tobydiamonds/kosmo-16-channel-midi-sequencer/frontpanel mockup.png

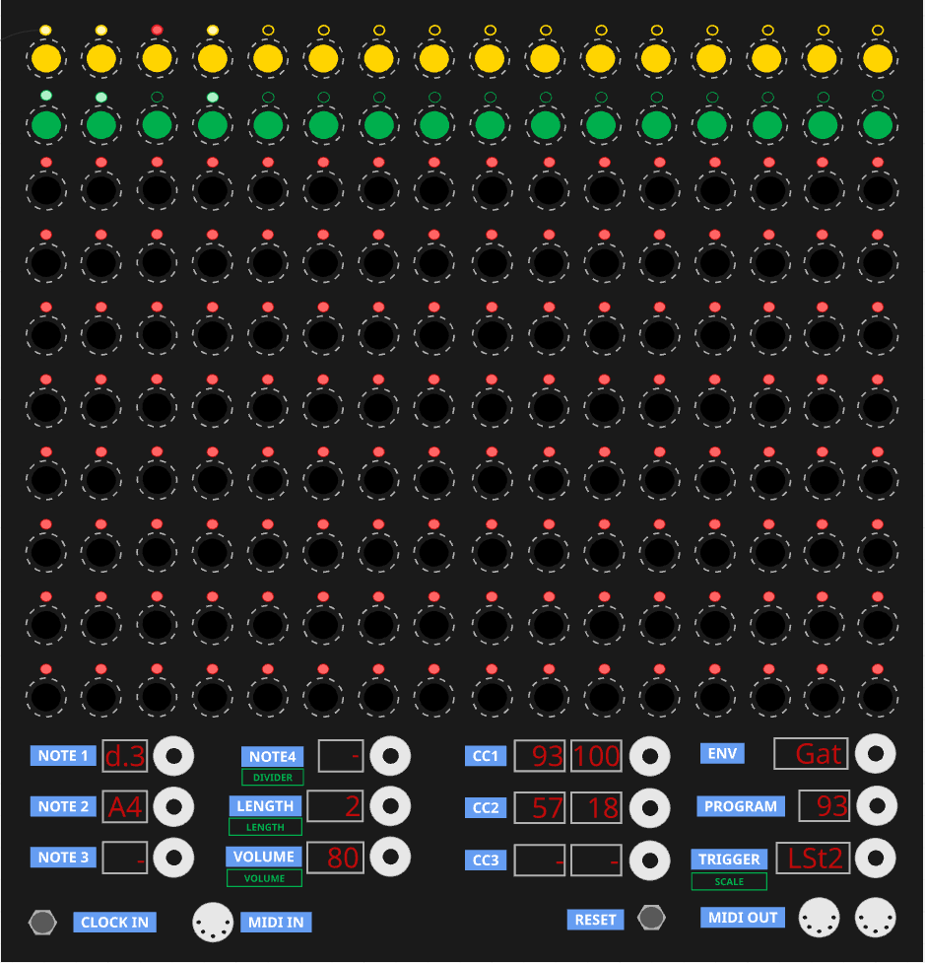
frontpanel mockup.png
