tobydiamonds/kosmo-16-channel-midi-sequencer/kosmo-16-channel-sequencer-centered.png

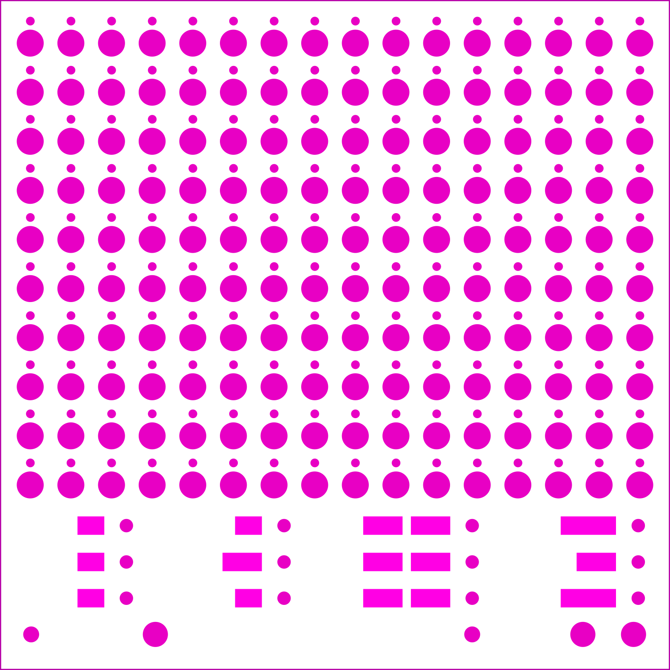
kosmo-16-channel-sequencer-centered.png
