tobydiamonds/kosmo-16-channel-midi-sequencer/kosmo-16-channel-sequencer-centered.pdf

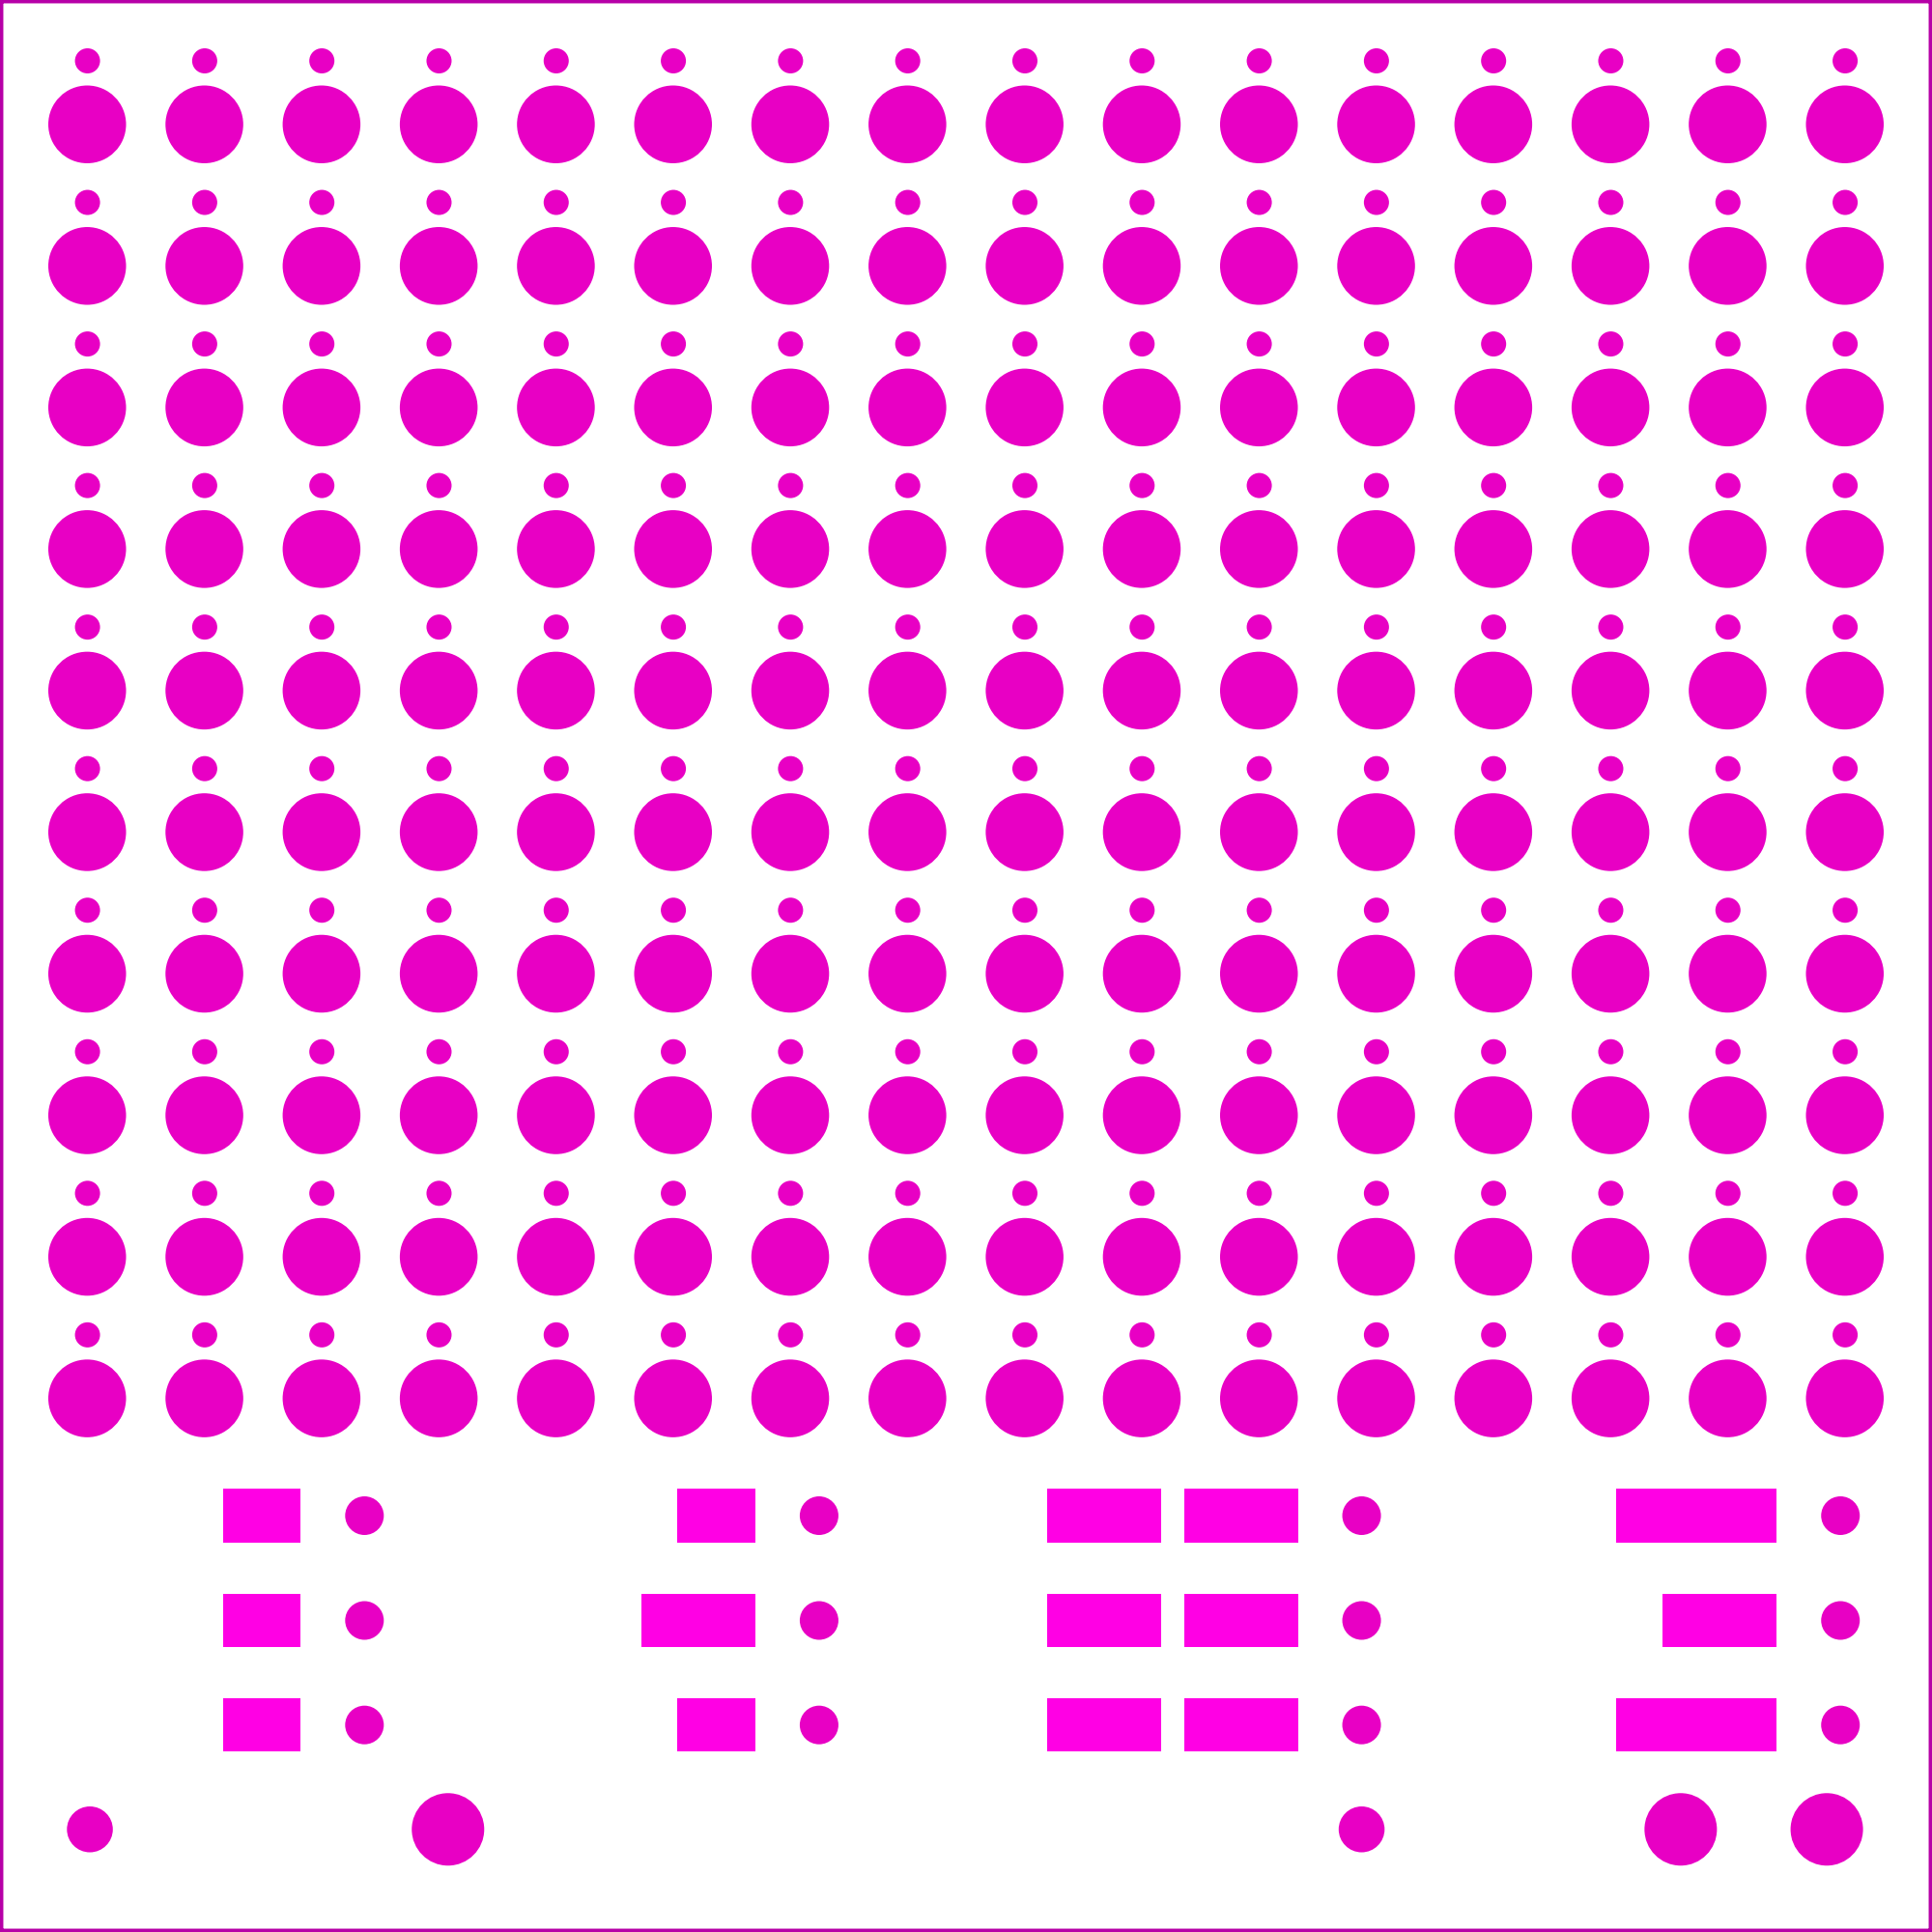
[picture p3: page 1]
