tobydiamonds/kosmo-16-channel-midi-sequencer/hardware/kosmo-16-channel-sequencer-row-board/kosmo-16-channel-sequencer-row-board.kicad_pcb

## KiCad design hardware/kosmo-16-channel-sequencer-row-board/kosmo-16-channel-sequencer-row-board.kicad_pcb (2026-09-22)

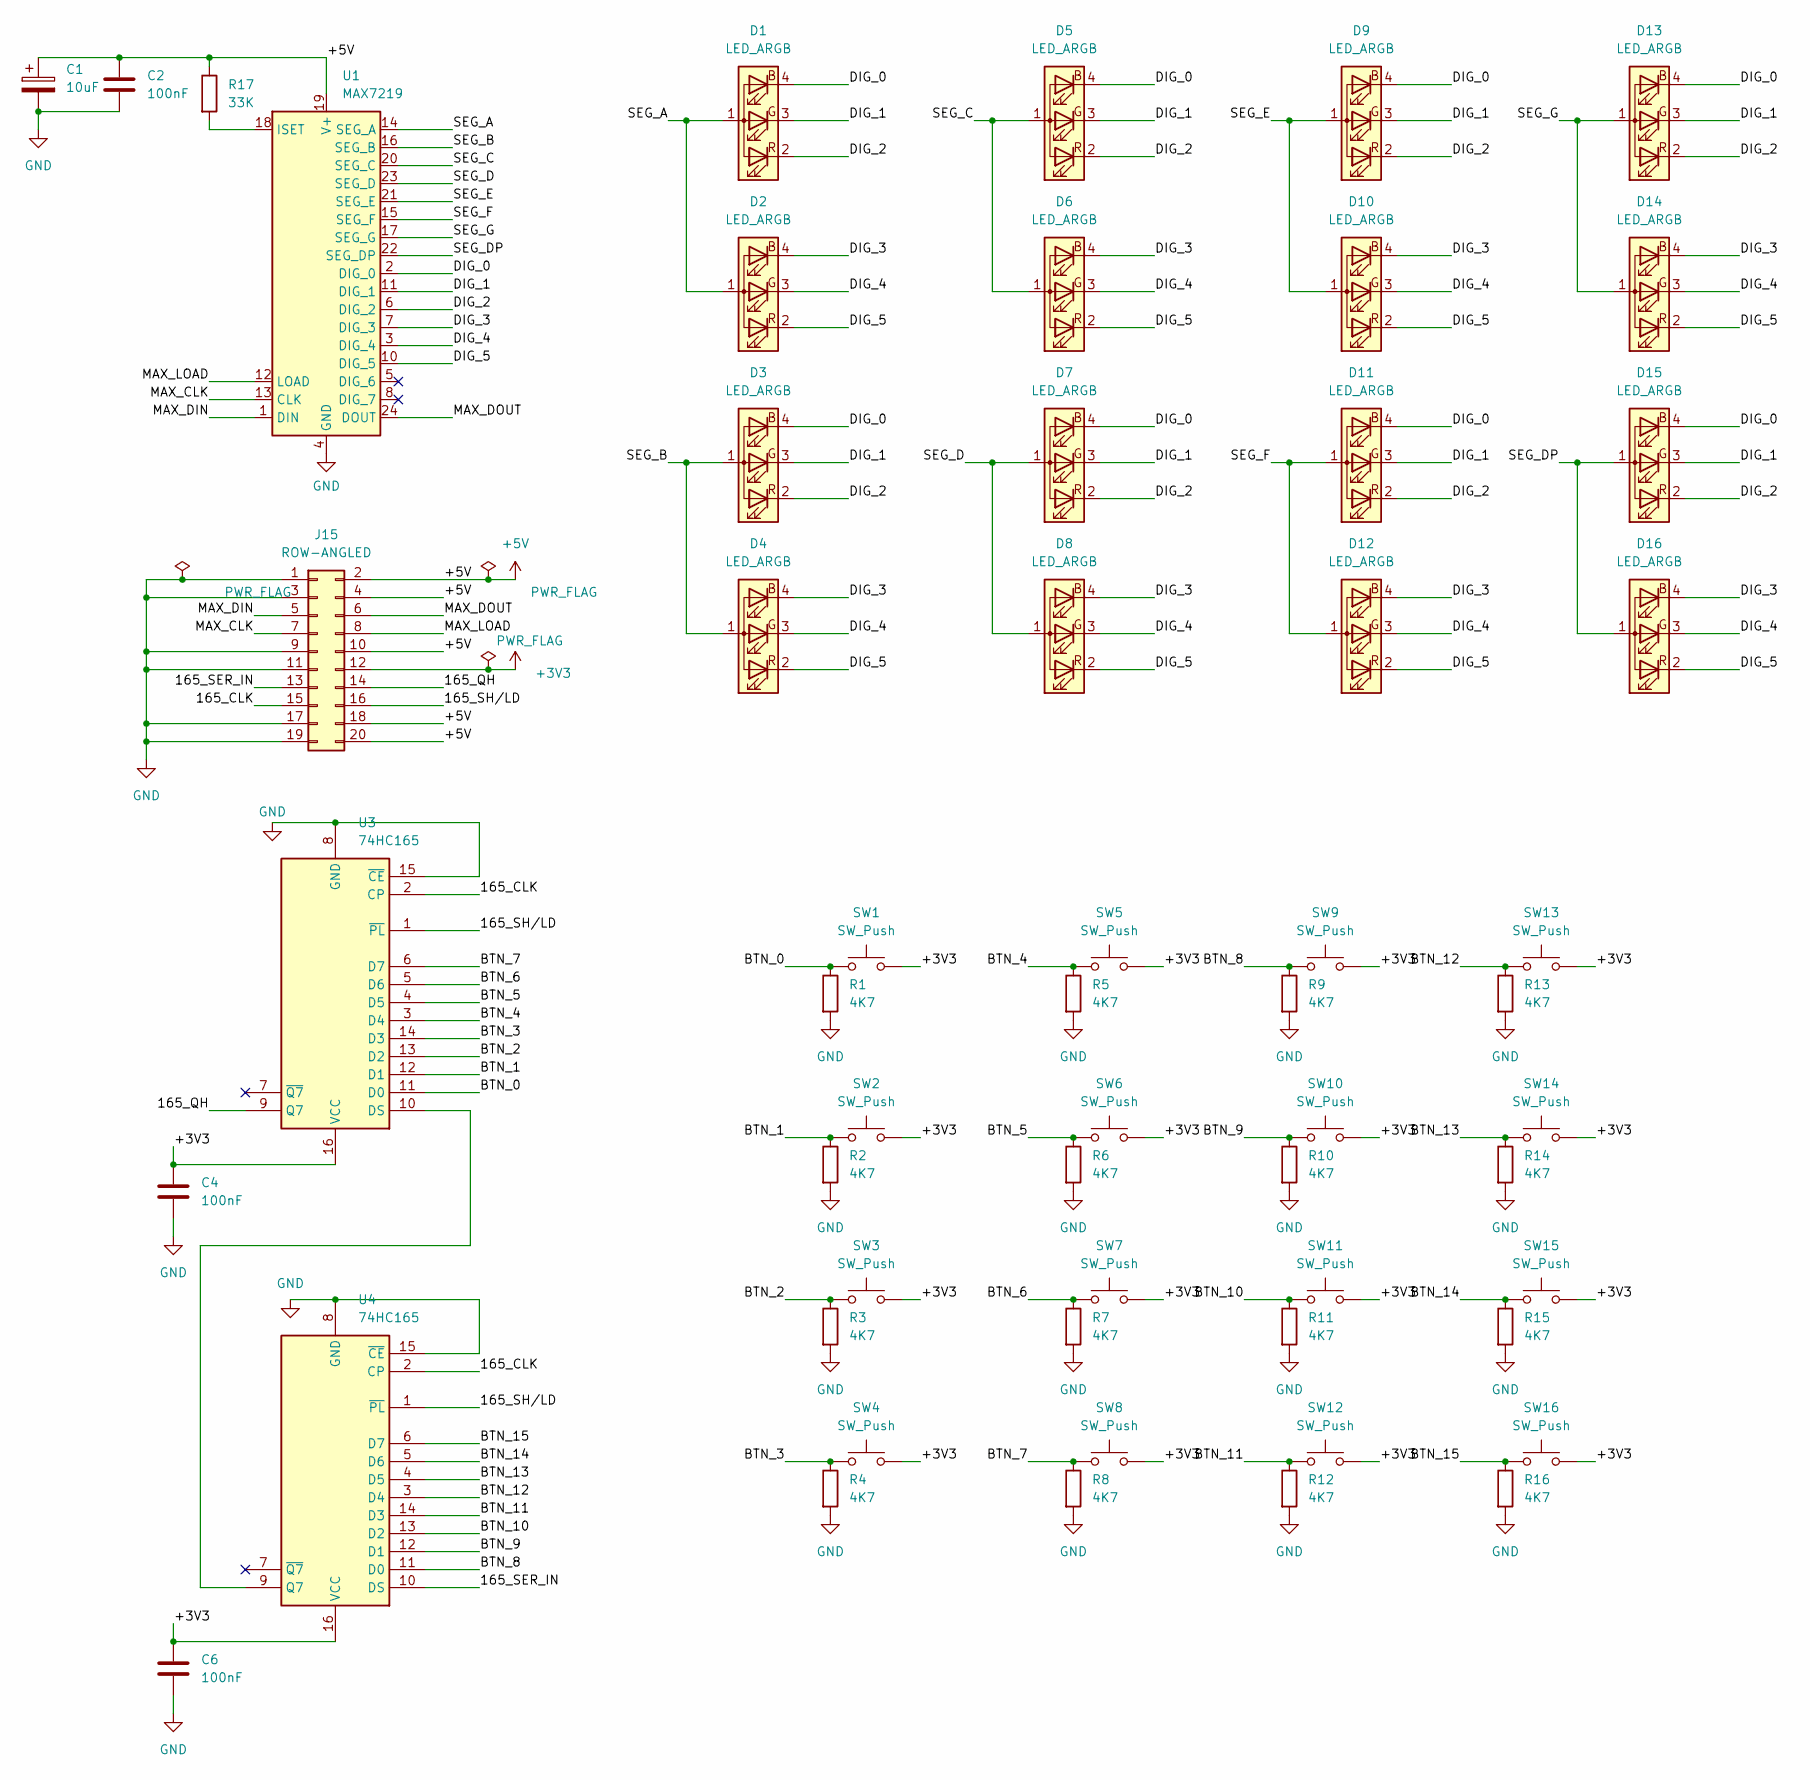
[picture p4: schematic kosmo-16-channel-sequencer-row-board.kicad_sch]

Parts:
C1: 10uF; CP_Radial_D6.3mm_P2.50mm
C2, C4, C6: 100nF; C_Disc_D5.0mm_W2.5mm_P5.00mm
D1, D2, D3, D4, D5, D6, D7, D8, D9, D10, D11, D12, D13, D14, D15, D16: LED_ARGB; LED_D5.0mm-4_RGB-common-anode
J15: ROW-ANGLED; PinHeader_2x10_P2.54mm_Vertical
R1, R2, R3, R4, R5, R6, R7, R8, R9, R10, R11, R12, R13, R14, R15, R16: 4K7; R_Axial_DIN0207_L6.3mm_D2.5mm_P7.62mm_Horizontal
R17: 33K; R_Axial_DIN0207_L6.3mm_D2.5mm_P7.62mm_Horizontal
SW1, SW2, SW3, SW4, SW5, SW6, SW7, SW8, SW9, SW10, SW11, SW12, SW13, SW14, SW15, SW16: SW_Push; PinHeader_1x02_P2.54mm_Vertical
U1: MAX7219; SMDIP-24_W15.24mm
U3, U4: 74HC165; DIP-16_W7.62mm

Connections:
+3V3: C4.1, C6.1, J15.12, SW1.2, SW2.2, SW3.2, SW4.2, SW5.2, SW6.2, SW7.2, SW8.2, SW9.2, SW10.2, SW11.2, SW12.2, SW13.2, SW14.2, SW15.2, SW16.2, U3.16 (VCC), U4.16 (VCC)
+5V: C1.1, C2.1, J15.2, J15.4, J15.10, J15.18, J15.20, R17.1, U1.19 (V+)
/165_CLK: J15.15, U3.2 (CP), U4.2 (CP)
/165_QH: J15.14, U3.9 (Q7)
/165_SER_IN: J15.13, U4.10 (DS)
/165_SH/LD: J15.16, U3.1 (~PL), U4.1 (~PL)
/BTN_0: R1.1, SW1.1, U3.11 (D0)
/BTN_1: R2.1, SW2.1, U3.12 (D1)
/BTN_2: R3.1, SW3.1, U3.13 (D2)
/BTN_3: R4.1, SW4.1, U3.14 (D3)
/BTN_4: R5.1, SW5.1, U3.3 (D4)
/BTN_5: R6.1, SW6.1, U3.4 (D5)
/BTN_6: R7.1, SW7.1, U3.5 (D6)
/BTN_7: R8.1, SW8.1, U3.6 (D7)
/BTN_8: R9.1, SW9.1, U4.11 (D0)
/BTN_9: R10.1, SW10.1, U4.12 (D1)
/BTN_10: R11.1, SW11.1, U4.13 (D2)
/BTN_11: R12.1, SW12.1, U4.14 (D3)
/BTN_12: R13.1, SW13.1, U4.3 (D4)
/BTN_13: R14.1, SW14.1, U4.4 (D5)
/BTN_14: R15.1, SW15.1, U4.5 (D6)
/BTN_15: R16.1, SW16.1, U4.6 (D7)
/DIG_0: D1.4 (BK), D3.4 (BK), D5.4 (BK), D7.4 (BK), D9.4 (BK), D11.4 (BK), D13.4 (BK), D15.4 (BK), U1.2 (DIG_0)
/DIG_1: D1.3 (GK), D3.3 (GK), D5.3 (GK), D7.3 (GK), D9.3 (GK), D11.3 (GK), D13.3 (GK), D15.3 (GK), U1.11 (DIG_1)
/DIG_2: D1.2 (RK), D3.2 (RK), D5.2 (RK), D7.2 (RK), D9.2 (RK), D11.2 (RK), D13.2 (RK), D15.2 (RK), U1.6 (DIG_2)
/DIG_3: D2.4 (BK), D4.4 (BK), D6.4 (BK), D8.4 (BK), D10.4 (BK), D12.4 (BK), D14.4 (BK), D16.4 (BK), U1.7 (DIG_3)
/DIG_4: D2.3 (GK), D4.3 (GK), D6.3 (GK), D8.3 (GK), D10.3 (GK), D12.3 (GK), D14.3 (GK), D16.3 (GK), U1.3 (DIG_4)
/DIG_5: D2.2 (RK), D4.2 (RK), D6.2 (RK), D8.2 (RK), D10.2 (RK), D12.2 (RK), D14.2 (RK), D16.2 (RK), U1.10 (DIG_5)
/MAX_CLK: J15.7, U1.13 (CLK)
/MAX_DIN: J15.5, U1.1 (DIN)
/MAX_DOUT: J15.6, U1.24 (DOUT)
/MAX_LOAD: J15.8, U1.12 (LOAD)
/SEG_A: D1.1 (A), D2.1 (A), U1.14 (SEG_A)
/SEG_B: D3.1 (A), D4.1 (A), U1.16 (SEG_B)
/SEG_C: D5.1 (A), D6.1 (A), U1.20 (SEG_C)
/SEG_D: D7.1 (A), D8.1 (A), U1.23 (SEG_D)
/SEG_DP: D15.1 (A), D16.1 (A), U1.22 (SEG_DP)
/SEG_E: D9.1 (A), D10.1 (A), U1.21 (SEG_E)
/SEG_F: D11.1 (A), D12.1 (A), U1.15 (SEG_F)
/SEG_G: D13.1 (A), D14.1 (A), U1.17 (SEG_G)
GND: C1.2, C2.2, C4.2, C6.2, J15.1, J15.3, J15.9, J15.11, J15.17, J15.19, R1.2, R2.2, R3.2, R4.2, R5.2, R6.2, R7.2, R8.2, R9.2, R10.2, R11.2, R12.2, R13.2, R14.2, R15.2, R16.2, U1.4 (GND), U1.9 (GND), U3.8 (GND), U3.15 (~CE), U4.8 (GND), U4.15 (~CE)
unnamed: R17.2, U1.18 (ISET)
unnamed: U3.10 (DS), U4.9 (Q7)

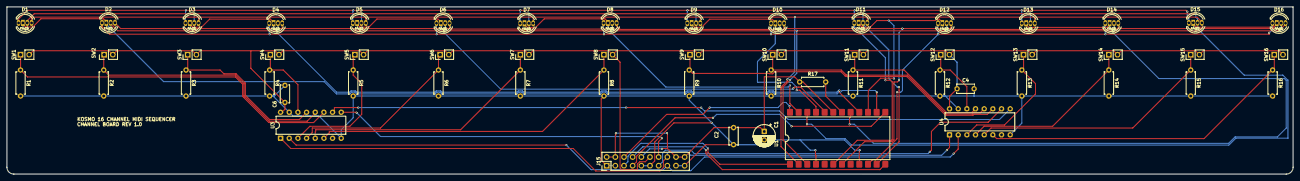
[picture p5: board kosmo-16-channel-sequencer-row-board.kicad_pcb from above]

Board: 2 copper layers, 377.0 x 49.0 mm, 57 parts (0 on the bottom side), 43 nets.
