tobydiamonds/kosmo-16-channel-midi-sequencer/hardware/kosmo-16-channel-sequencer-steps-settings-board/kosmo-16-channel-sequencer-step-settings-board.kicad_pcb

## KiCad design hardware/kosmo-16-channel-sequencer-steps-settings-board/kosmo-16-channel-sequencer-step-settings-board.kicad_pcb (2026-09-22)

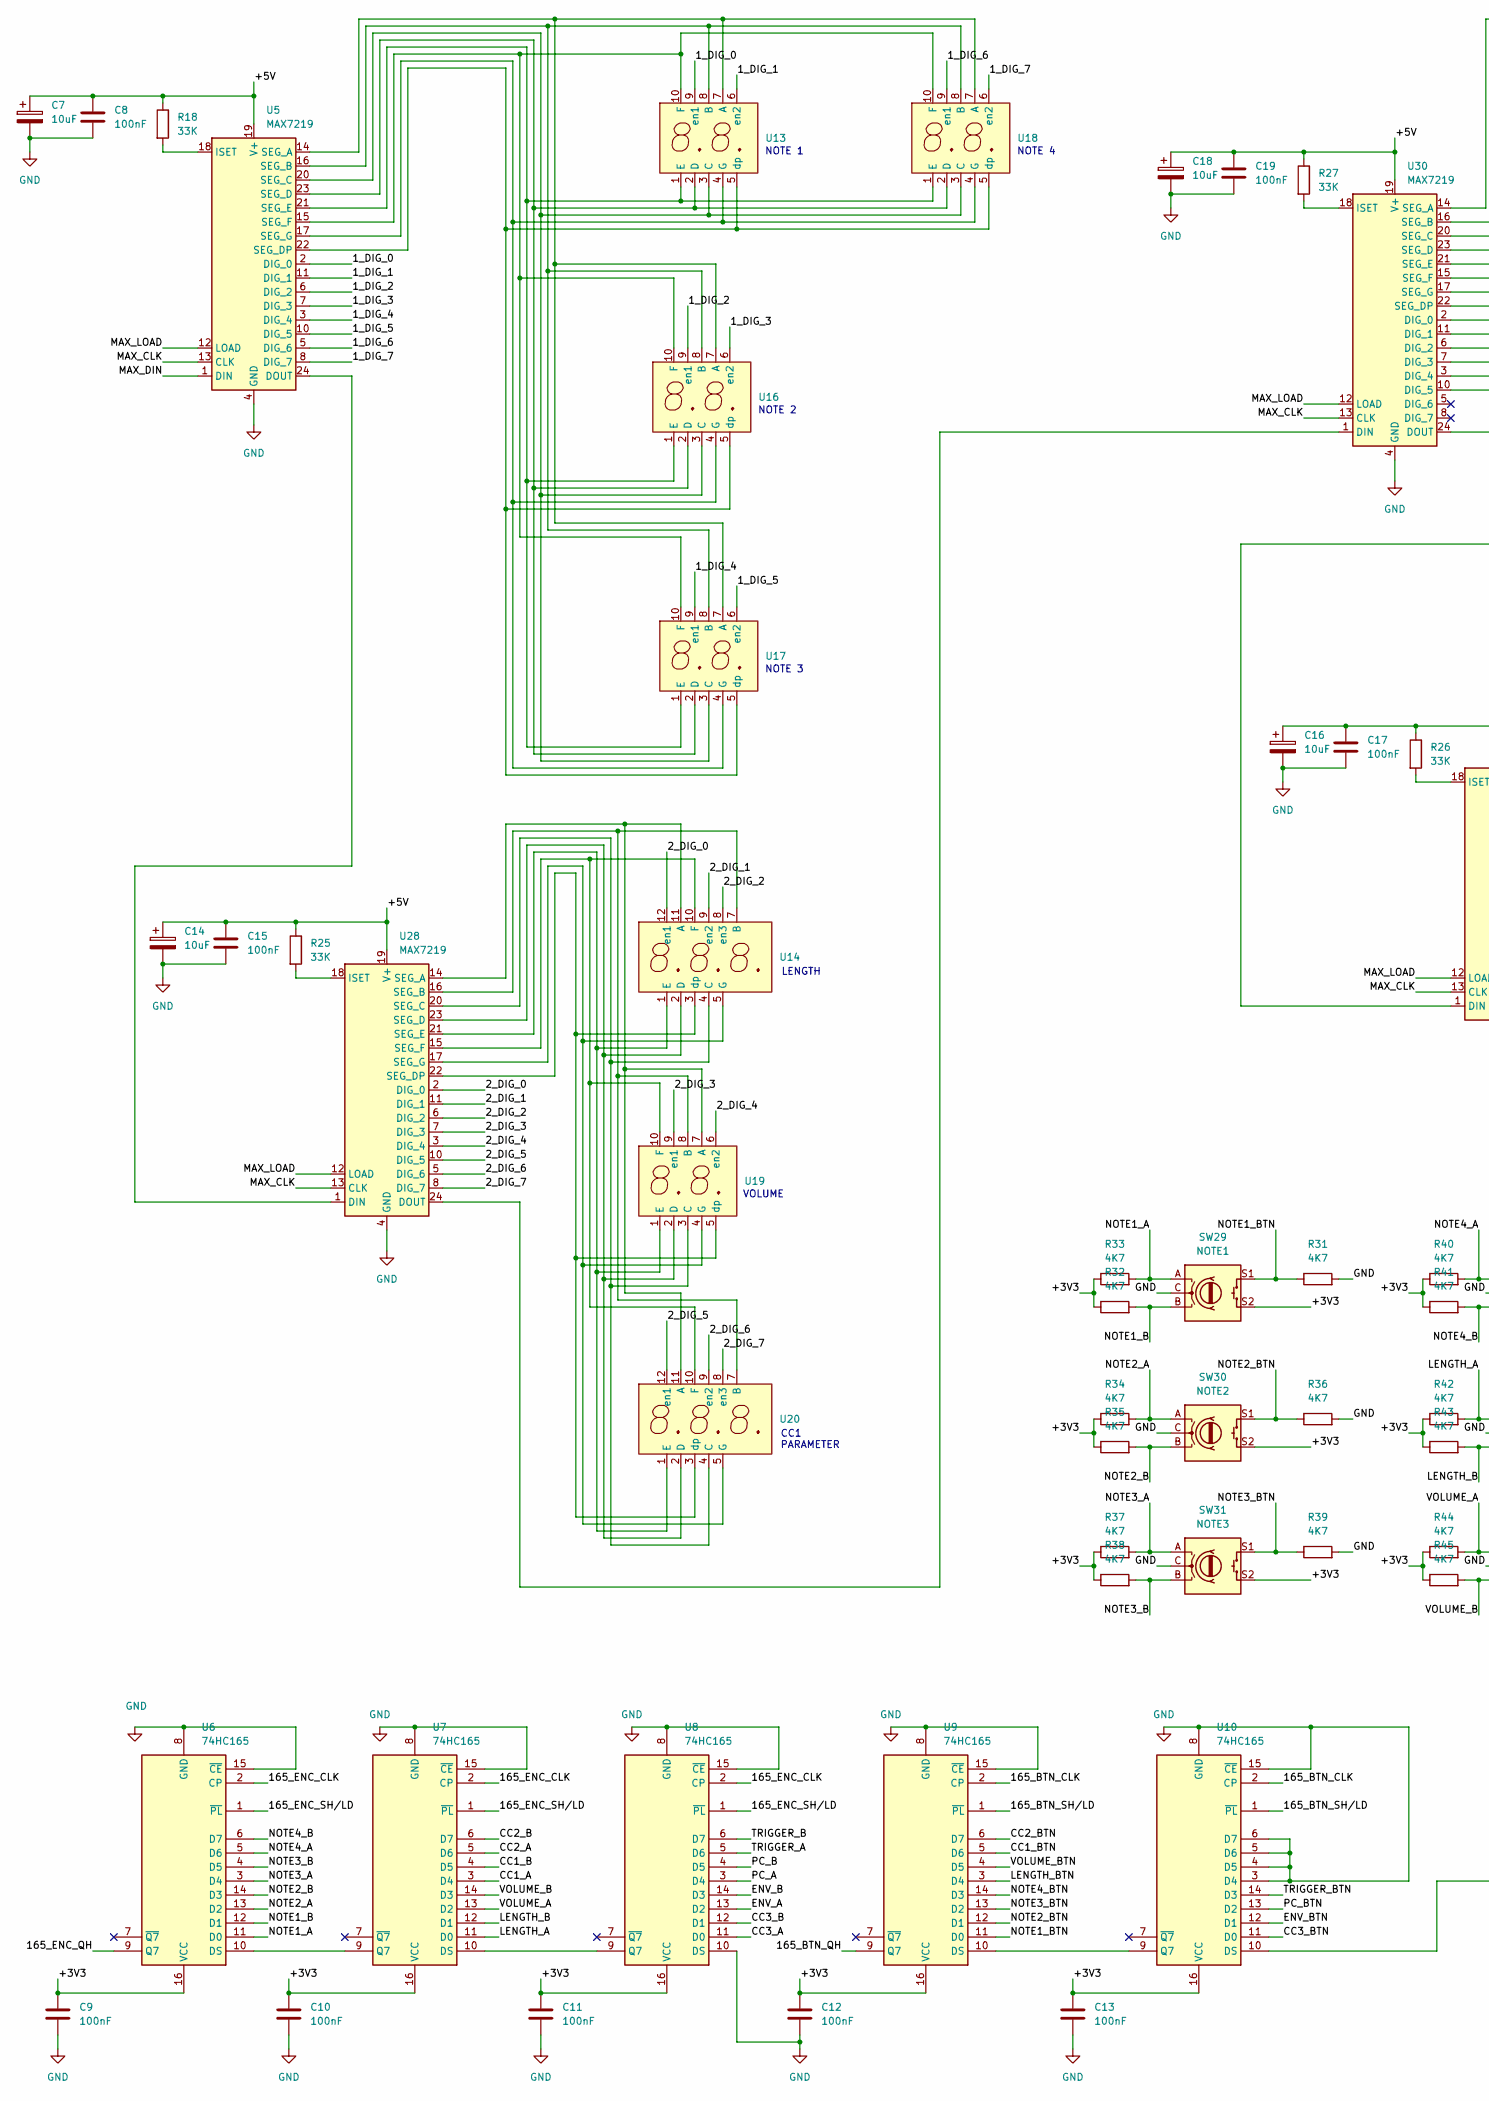
[picture p6: schematic kosmo-16-channel-sequencer-step-settings-board.kicad_sch, part in row 1, column 1]

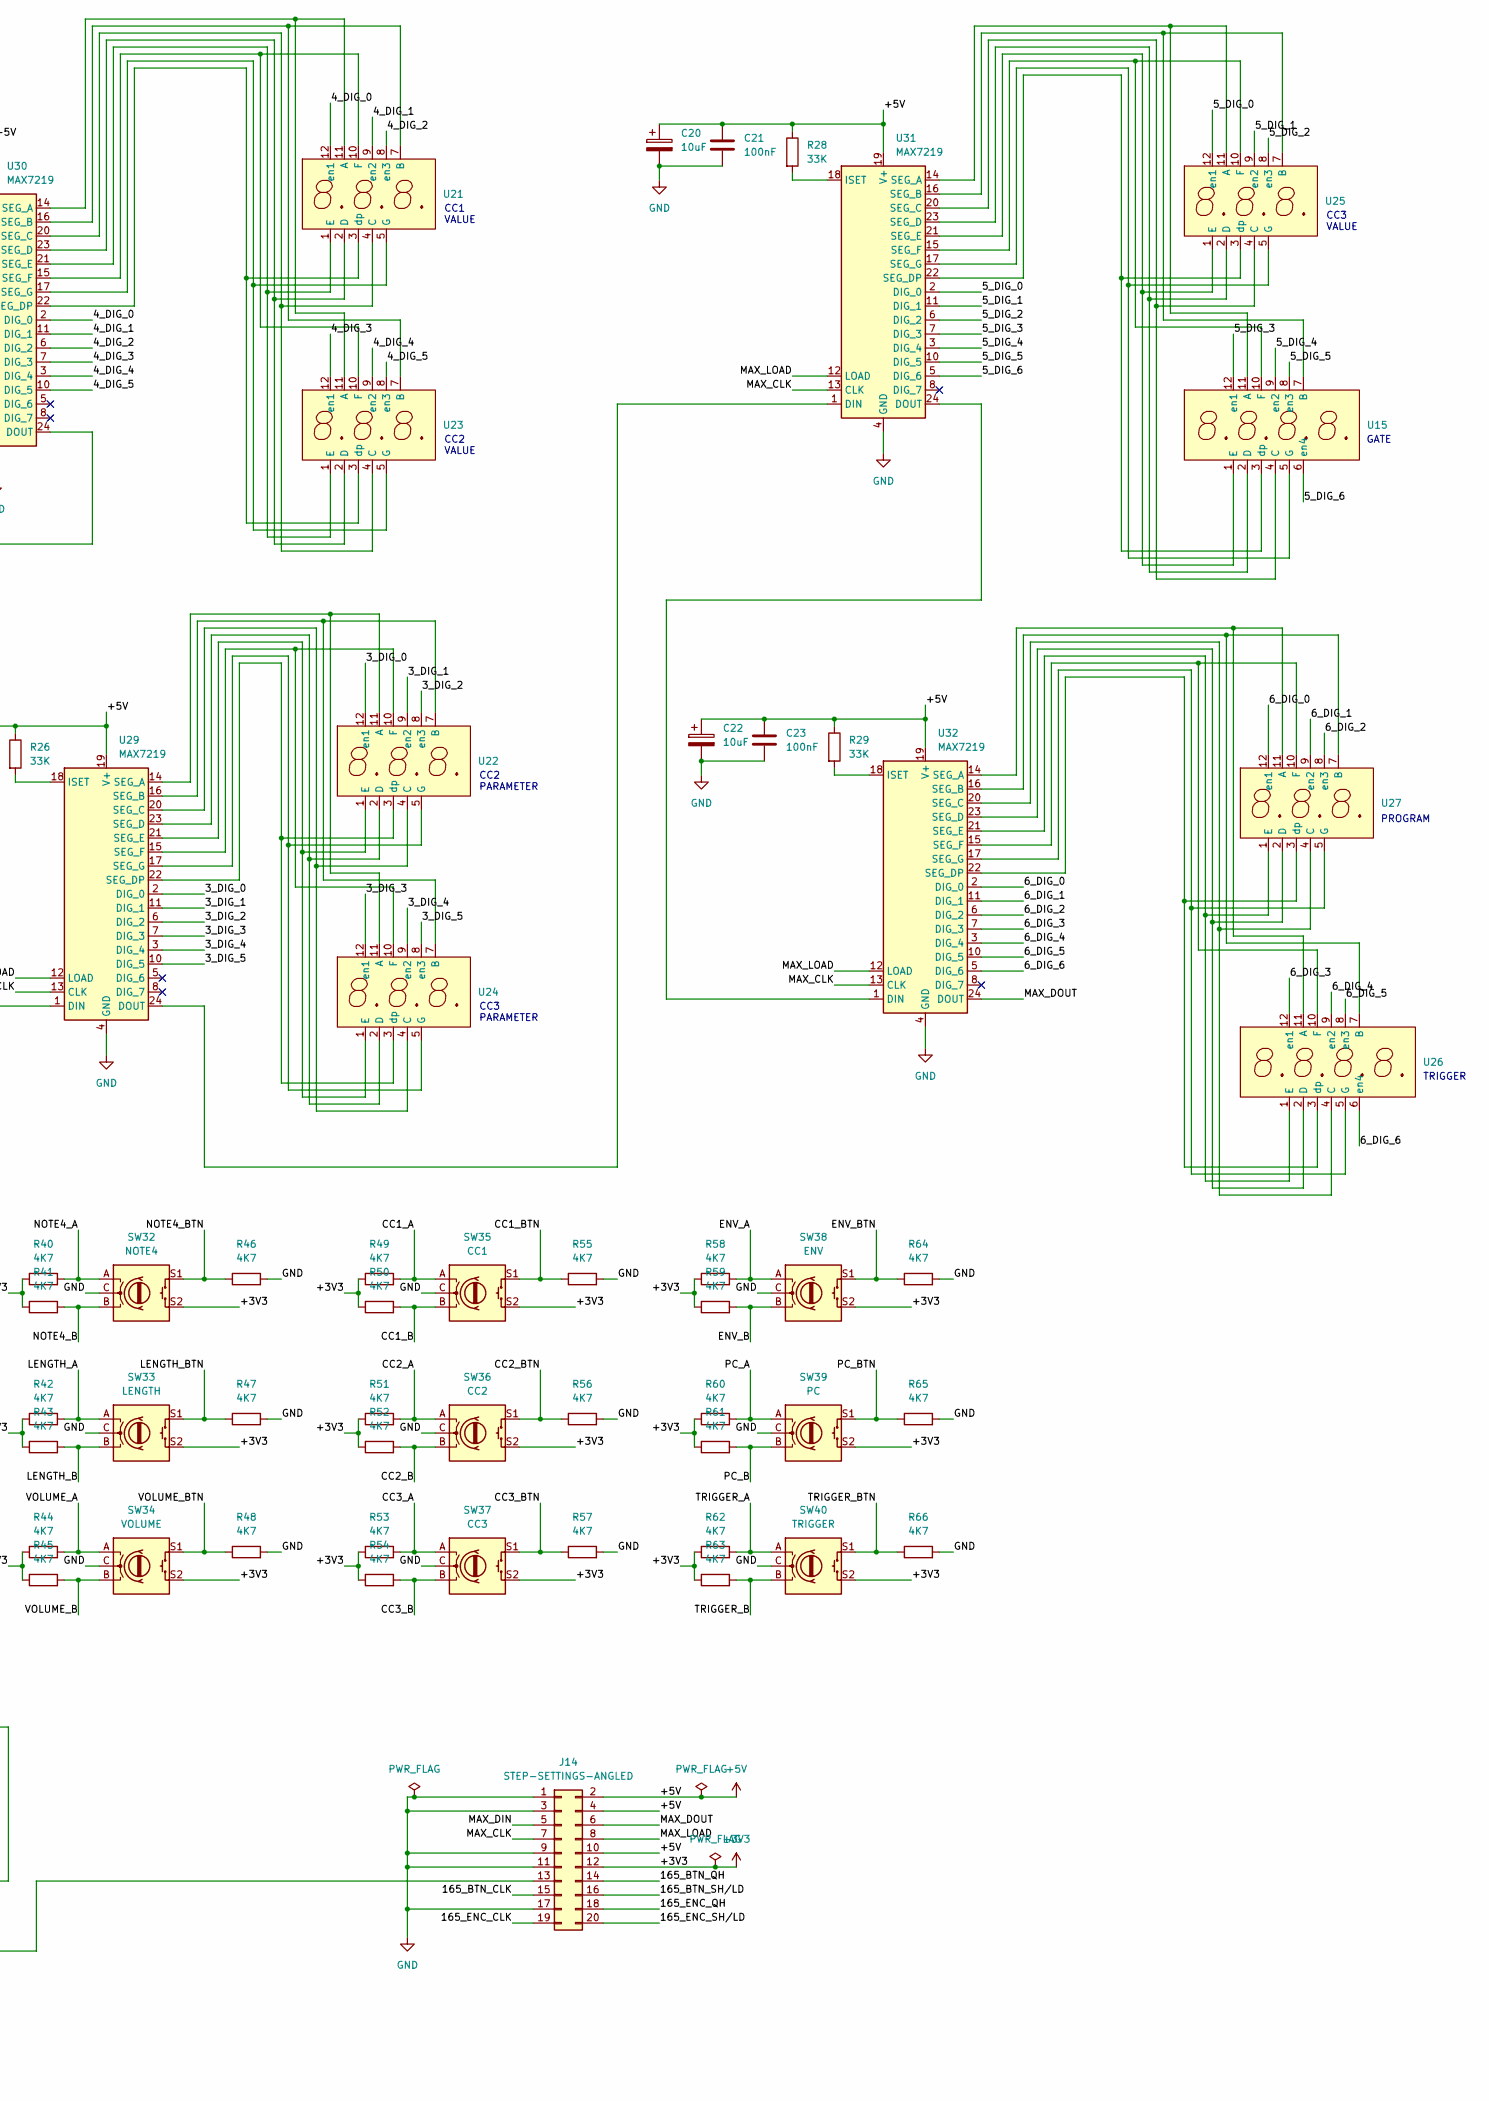
[picture p7: schematic kosmo-16-channel-sequencer-step-settings-board.kicad_sch, part in row 1, column 2]

Parts:
C7, C14, C16, C18, C20, C22: 10uF; CP_Radial_D6.3mm_P2.50mm
C8, C9, C10, C11, C12, C13, C15, C17, C19, C21, C23: 100nF; C_Disc_D5.0mm_W2.5mm_P5.00mm
J14: STEP-SETTINGS-ANGLED; PinHeader_2x10_P2.54mm_Vertical
R18, R25, R26, R27, R28, R29: 33K; R_Axial_DIN0207_L6.3mm_D2.5mm_P7.62mm_Horizontal
R31, R32, R33, R34, R35, R36, R37, R38, R39, R40, R41, R42, R43, R44, R45, R46, R47, R48, R49, R50, R51, R52, R53, R54, R55, R56, R57, R58, R59, R60, R61, R62, R63, R64, R65, R66: 4K7; R_Axial_DIN0207_L6.3mm_D2.5mm_P7.62mm_Horizontal
SW29: NOTE1; RotaryEncoder_Bourns_Vertical_PEC12R-3x17F-Sxxxx
SW30: NOTE2; RotaryEncoder_Bourns_Vertical_PEC12R-3x17F-Sxxxx
SW31: NOTE3; RotaryEncoder_Bourns_Vertical_PEC12R-3x17F-Sxxxx
SW32: NOTE4; RotaryEncoder_Bourns_Vertical_PEC12R-3x17F-Sxxxx
SW33: LENGTH; RotaryEncoder_Bourns_Vertical_PEC12R-3x17F-Sxxxx
SW34: VOLUME; RotaryEncoder_Bourns_Vertical_PEC12R-3x17F-Sxxxx
SW35: CC1; RotaryEncoder_Bourns_Vertical_PEC12R-3x17F-Sxxxx
SW36: CC2; RotaryEncoder_Bourns_Vertical_PEC12R-3x17F-Sxxxx
SW37: CC3; RotaryEncoder_Bourns_Vertical_PEC12R-3x17F-Sxxxx
SW38: ENV; RotaryEncoder_Bourns_Vertical_PEC12R-3x17F-Sxxxx
SW39: PC; RotaryEncoder_Bourns_Vertical_PEC12R-3x17F-Sxxxx
SW40: TRIGGER; RotaryEncoder_Bourns_Vertical_PEC12R-3x17F-Sxxxx
U5, U28, U29, U30, U31, U32: MAX7219; SMDIP-24_W15.24mm
U6, U7, U8, U9, U10: 74HC165; DIP-16_W7.62mm
U13, U16, U17, U18, U19: DIP-10_W7.62mm
U14, U15, U20, U21, U22, U23, U24, U25, U26, U27: DIP-12_W7.62mm

Connections:
+3V3: C9.1, C10.1, C11.1, C12.1, C13.1, J14.12, R32.1, R33.1, R34.1, R35.1, R37.1, R38.1, R40.1, R41.1, R42.1, R43.1, R44.1, R45.1, R49.1, R50.1, R51.1, R52.1, R53.1, R54.1, R58.1, R59.1, R60.1, R61.1, R62.1, R63.1, SW29.S2, SW30.S2, SW31.S2, SW32.S2, SW33.S2, SW34.S2, SW35.S2, SW36.S2, SW37.S2, SW38.S2, SW39.S2, SW40.S2, U6.16 (VCC), U7.16 (VCC), U8.16 (VCC), U9.16 (VCC), U10.16 (VCC)
+5V: C7.1, C8.1, C14.1, C15.1, C16.1, C17.1, C18.1, C19.1, C20.1, C21.1, C22.1, C23.1, J14.2, J14.4, J14.10, R18.1, R25.1, R26.1, R27.1, R28.1, R29.1, U5.19 (V+), U28.19 (V+), U29.19 (V+), U30.19 (V+), U31.19 (V+), U32.19 (V+)
/1_DIG_0: U5.2 (DIG_0), U13.9 (en1)
/1_DIG_1: U5.11 (DIG_1), U13.6 (en2)
/1_DIG_2: U5.6 (DIG_2), U16.9 (en1)
/1_DIG_3: U5.7 (DIG_3), U16.6 (en2)
/1_DIG_4: U5.3 (DIG_4), U17.9 (en1)
/1_DIG_5: U5.10 (DIG_5), U17.6 (en2)
/1_DIG_6: U5.5 (DIG_6), U18.9 (en1)
/1_DIG_7: U5.8 (DIG_7), U18.6 (en2)
/2_DIG_0: U14.12 (en1), U28.2 (DIG_0)
/2_DIG_1: U14.9 (en2), U28.11 (DIG_1)
/2_DIG_2: U14.8 (en3), U28.6 (DIG_2)
/2_DIG_3: U19.9 (en1), U28.7 (DIG_3)
/2_DIG_4: U19.6 (en2), U28.3 (DIG_4)
/2_DIG_5: U20.12 (en1), U28.10 (DIG_5)
/2_DIG_6: U20.9 (en2), U28.5 (DIG_6)
/2_DIG_7: U20.8 (en3), U28.8 (DIG_7)
/3_DIG_0: U22.12 (en1), U29.2 (DIG_0)
/3_DIG_1: U22.9 (en2), U29.11 (DIG_1)
/3_DIG_2: U22.8 (en3), U29.6 (DIG_2)
/3_DIG_3: U24.12 (en1), U29.7 (DIG_3)
/3_DIG_4: U24.9 (en2), U29.3 (DIG_4)
/3_DIG_5: U24.8 (en3), U29.10 (DIG_5)
/4_DIG_0: U21.12 (en1), U30.2 (DIG_0)
/4_DIG_1: U21.9 (en2), U30.11 (DIG_1)
/4_DIG_2: U21.8 (en3), U30.6 (DIG_2)
/4_DIG_3: U23.12 (en1), U30.7 (DIG_3)
/4_DIG_4: U23.9 (en2), U30.3 (DIG_4)
/4_DIG_5: U23.8 (en3), U30.10 (DIG_5)
/5_DIG_0: U25.12 (en1), U31.2 (DIG_0)
/5_DIG_1: U25.9 (en2), U31.11 (DIG_1)
/5_DIG_2: U25.8 (en3), U31.6 (DIG_2)
/5_DIG_3: U15.12 (en1), U31.7 (DIG_3)
/5_DIG_4: U15.9 (en2), U31.3 (DIG_4)
/5_DIG_5: U15.8 (en3), U31.10 (DIG_5)
/5_DIG_6: U15.6 (en4), U31.5 (DIG_6)
/6_DIG_0: U27.12 (en1), U32.2 (DIG_0)
/6_DIG_1: U27.9 (en2), U32.11 (DIG_1)
/6_DIG_2: U27.8 (en3), U32.6 (DIG_2)
/6_DIG_3: U26.12 (en1), U32.7 (DIG_3)
/6_DIG_4: U26.9 (en2), U32.3 (DIG_4)
/6_DIG_5: U26.8 (en3), U32.10 (DIG_5)
/6_DIG_6: U26.6 (en4), U32.5 (DIG_6)
/165_BTN_CLK: J14.15, U9.2 (CP), U10.2 (CP)
/165_BTN_QH: J14.14, U9.9 (Q7)
/165_BTN_SH/LD: J14.16, U9.1 (~PL), U10.1 (~PL)
/165_ENC_CLK: J14.19, U6.2 (CP), U7.2 (CP), U8.2 (CP)
/165_ENC_QH: J14.18, U6.9 (Q7)
/165_ENC_SH/LD: J14.20, U6.1 (~PL), U7.1 (~PL), U8.1 (~PL)
/CC1_A: R49.2, SW35.A, U7.3 (D4)
/CC1_B: R50.2, SW35.B, U7.4 (D5)
/CC1_BTN: R55.1, SW35.S1, U9.5 (D6)
/CC2_A: R51.2, SW36.A, U7.5 (D6)
/CC2_B: R52.2, SW36.B, U7.6 (D7)
/CC2_BTN: R56.1, SW36.S1, U9.6 (D7)
/CC3_A: R53.2, SW37.A, U8.11 (D0)
/CC3_B: R54.2, SW37.B, U8.12 (D1)
/CC3_BTN: R57.1, SW37.S1, U10.11 (D0)
/ENV_A: R58.2, SW38.A, U8.13 (D2)
/ENV_B: R59.2, SW38.B, U8.14 (D3)
/ENV_BTN: R64.1, SW38.S1, U10.12 (D1)
/LENGTH_A: R42.2, SW33.A, U7.11 (D0)
/LENGTH_B: R43.2, SW33.B, U7.12 (D1)
/LENGTH_BTN: R47.1, SW33.S1, U9.3 (D4)
/MAX_CLK: J14.7, U5.13 (CLK), U28.13 (CLK), U29.13 (CLK), U30.13 (CLK), U31.13 (CLK), U32.13 (CLK)
/MAX_DIN: J14.5, U5.1 (DIN)
/MAX_DOUT: J14.6, U32.24 (DOUT)
/MAX_LOAD: J14.8, U5.12 (LOAD), U28.12 (LOAD), U29.12 (LOAD), U30.12 (LOAD), U31.12 (LOAD), U32.12 (LOAD)
/NOTE1_A: R33.2, SW29.A, U6.11 (D0)
/NOTE1_B: R32.2, SW29.B, U6.12 (D1)
/NOTE1_BTN: R31.1, SW29.S1, U9.11 (D0)
/NOTE2_A: R34.2, SW30.A, U6.13 (D2)
/NOTE2_B: R35.2, SW30.B, U6.14 (D3)
/NOTE2_BTN: R36.1, SW30.S1, U9.12 (D1)
/NOTE3_A: R37.2, SW31.A, U6.3 (D4)
/NOTE3_B: R38.2, SW31.B, U6.4 (D5)
/NOTE3_BTN: R39.1, SW31.S1, U9.13 (D2)
/NOTE4_A: R40.2, SW32.A, U6.5 (D6)
/NOTE4_B: R41.2, SW32.B, U6.6 (D7)
/NOTE4_BTN: R46.1, SW32.S1, U9.14 (D3)
/PC_A: R60.2, SW39.A, U8.3 (D4)
/PC_B: R61.2, SW39.B, U8.4 (D5)
/PC_BTN: R65.1, SW39.S1, U10.13 (D2)
/TRIGGER_A: R62.2, SW40.A, U8.5 (D6)
/TRIGGER_B: R63.2, SW40.B, U8.6 (D7)
/TRIGGER_BTN: R66.1, SW40.S1, U10.14 (D3)
/VOLUME_A: R44.2, SW34.A, U7.13 (D2)
/VOLUME_B: R45.2, SW34.B, U7.14 (D3)
/VOLUME_BTN: R48.1, SW34.S1, U9.4 (D5)
GND: C7.2, C8.2, C9.2, C10.2, C11.2, C12.2, C13.2, C14.2, C15.2, C16.2, C17.2, C18.2, C19.2, C20.2, C21.2, C22.2, C23.2, J14.1, J14.3, J14.9, J14.11, J14.17, R31.2, R36.2, R39.2, R46.2, R47.2, R48.2, R55.2, R56.2, R57.2, R64.2, R65.2, R66.2, SW29.C, SW30.C, SW31.C, SW32.C, SW33.C, SW34.C, SW35.C, SW36.C, SW37.C, SW38.C, SW39.C, SW40.C, U5.4 (GND), U5.9 (GND), U6.8 (GND), U6.15 (~CE), U7.8 (GND), U7.15 (~CE), U8.8 (GND), U8.10 (DS), U8.15 (~CE), U9.8 (GND), U9.15 (~CE), U10.3 (D4), U10.4 (D5), U10.5 (D6), U10.6 (D7), U10.8 (GND), U10.15 (~CE), U28.4 (GND), U28.9 (GND), U29.4 (GND), U29.9 (GND), U30.4 (GND), U30.9 (GND), U31.4 (GND), U31.9 (GND), U32.4 (GND), U32.9 (GND)
unnamed: J14.13, U10.10 (DS)
unnamed: R18.2, U5.18 (ISET)
unnamed: U6.10 (DS), U7.9 (Q7)
unnamed: U7.10 (DS), U8.9 (Q7)
unnamed: U9.10 (DS), U10.9 (Q7)
unnamed: U5.14 (SEG_A), U13.7 (A), U16.7 (A), U17.7 (A), U18.7 (A)
unnamed: U5.16 (SEG_B), U13.8 (B), U16.8 (B), U17.8 (B), U18.8 (B)
unnamed: U5.20 (SEG_C), U13.3 (C), U16.3 (C), U17.3 (C), U18.3 (C)
unnamed: U5.23 (SEG_D), U13.2 (D), U16.2 (D), U17.2 (D), U18.2 (D)
unnamed: U5.21 (SEG_E), U13.1 (E), U16.1 (E), U17.1 (E), U18.1 (E)
unnamed: U5.15 (SEG_F), U13.10 (F), U16.10 (F), U17.10 (F), U18.10 (F)
unnamed: U5.17 (SEG_G), U13.4 (G), U16.4 (G), U17.4 (G), U18.4 (G)
unnamed: U5.22 (SEG_DP), U13.5 (dp), U16.5 (dp), U17.5 (dp), U18.5 (dp)
unnamed: U14.11 (A), U19.7 (A), U20.11 (A), U28.14 (SEG_A)
unnamed: U14.7 (B), U19.8 (B), U20.7 (B), U28.16 (SEG_B)
unnamed: U14.4 (C), U19.3 (C), U20.4 (C), U28.20 (SEG_C)
unnamed: U14.2 (D), U19.2 (D), U20.2 (D), U28.23 (SEG_D)
unnamed: U14.1 (E), U19.1 (E), U20.1 (E), U28.21 (SEG_E)
unnamed: U14.10 (F), U19.10 (F), U20.10 (F), U28.15 (SEG_F)
unnamed: U14.5 (G), U19.4 (G), U20.5 (G), U28.17 (SEG_G)
unnamed: U14.3 (dp), U19.5 (dp), U20.3 (dp), U28.22 (SEG_DP)
unnamed: U15.11 (A), U25.11 (A), U31.14 (SEG_A)
unnamed: U15.7 (B), U25.7 (B), U31.16 (SEG_B)
unnamed: U15.4 (C), U25.4 (C), U31.20 (SEG_C)
unnamed: U15.2 (D), U25.2 (D), U31.23 (SEG_D)
unnamed: U15.1 (E), U25.1 (E), U31.21 (SEG_E)
unnamed: U15.10 (F), U25.10 (F), U31.15 (SEG_F)
unnamed: U15.5 (G), U25.5 (G), U31.17 (SEG_G)
unnamed: U15.3 (dp), U25.3 (dp), U31.22 (SEG_DP)
unnamed: U21.11 (A), U23.11 (A), U30.14 (SEG_A)
unnamed: U21.7 (B), U23.7 (B), U30.16 (SEG_B)
unnamed: U21.4 (C), U23.4 (C), U30.20 (SEG_C)
unnamed: U21.2 (D), U23.2 (D), U30.23 (SEG_D)
unnamed: U21.1 (E), U23.1 (E), U30.21 (SEG_E)
unnamed: U21.10 (F), U23.10 (F), U30.15 (SEG_F)
unnamed: U21.5 (G), U23.5 (G), U30.17 (SEG_G)
unnamed: U21.3 (dp), U23.3 (dp), U30.22 (SEG_DP)
unnamed: U22.11 (A), U24.11 (A), U29.14 (SEG_A)
unnamed: U22.7 (B), U24.7 (B), U29.16 (SEG_B)
unnamed: U22.4 (C), U24.4 (C), U29.20 (SEG_C)
unnamed: U22.2 (D), U24.2 (D), U29.23 (SEG_D)
unnamed: U22.1 (E), U24.1 (E), U29.21 (SEG_E)
unnamed: U22.10 (F), U24.10 (F), U29.15 (SEG_F)
unnamed: U22.5 (G), U24.5 (G), U29.17 (SEG_G)
unnamed: U22.3 (dp), U24.3 (dp), U29.22 (SEG_DP)
unnamed: U26.11 (A), U27.11 (A), U32.14 (SEG_A)
unnamed: U26.7 (B), U27.7 (B), U32.16 (SEG_B)
unnamed: U26.4 (C), U27.4 (C), U32.20 (SEG_C)
unnamed: U26.2 (D), U27.2 (D), U32.23 (SEG_D)
unnamed: U26.1 (E), U27.1 (E), U32.21 (SEG_E)
unnamed: U26.10 (F), U27.10 (F), U32.15 (SEG_F)
unnamed: U26.5 (G), U27.5 (G), U32.17 (SEG_G)
unnamed: U26.3 (dp), U27.3 (dp), U32.22 (SEG_DP)
unnamed: U5.24 (DOUT), U28.1 (DIN)
unnamed: U28.24 (DOUT), U30.1 (DIN)
unnamed: R25.2, U28.18 (ISET)
unnamed: U29.1 (DIN), U30.24 (DOUT)
unnamed: U29.24 (DOUT), U31.1 (DIN)
unnamed: R26.2, U29.18 (ISET)
unnamed: R27.2, U30.18 (ISET)
unnamed: U31.24 (DOUT), U32.1 (DIN)
unnamed: R28.2, U31.18 (ISET)
unnamed: R29.2, U32.18 (ISET)

Notes on the sheet:
GATE
NOTE 4
NOTE 1
CC1 PARAMETER
NOTE 2
VOLUME
CC3 VALUE
PROGRAM
CC3 PARAMETER
TRIGGER
LENGTH
CC2 VALUE
CC1 VALUE
NOTE 3
CC2 PARAMETER

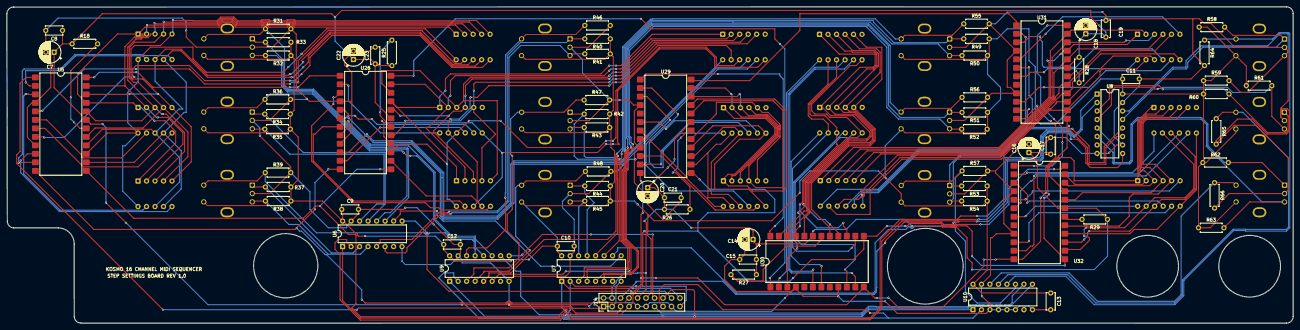
[picture p8: board kosmo-16-channel-sequencer-step-settings-board.kicad_pcb from above]

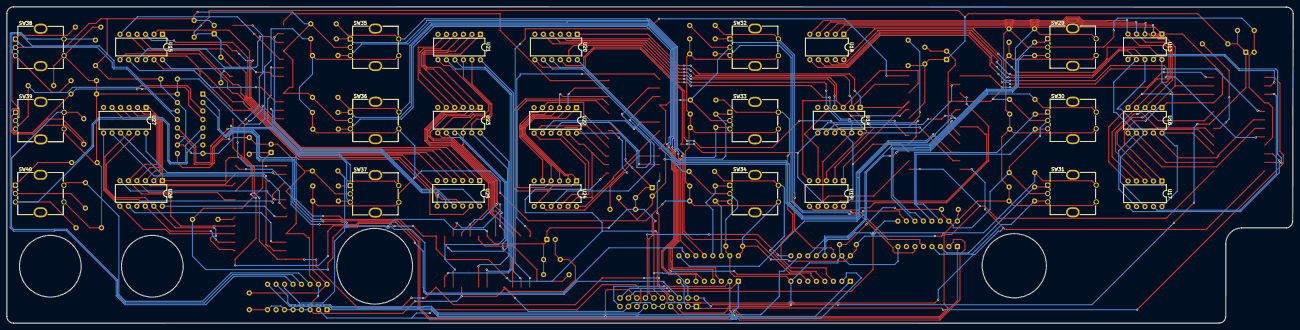
[picture p9: board kosmo-16-channel-sequencer-step-settings-board.kicad_pcb from below]

Board: 2 copper layers, 384.6 x 94.6 mm, 98 parts (27 on the bottom side), 154 nets.
