tobydiamonds/kosmo-16-channel-midi-sequencer/hardware/kosmo-16-channel-sequencer-main-board/kosmo-16-channel-sequencer-main-board.kicad_pcb

## KiCad design hardware/kosmo-16-channel-sequencer-main-board/kosmo-16-channel-sequencer-main-board.kicad_pcb (2026-09-22)

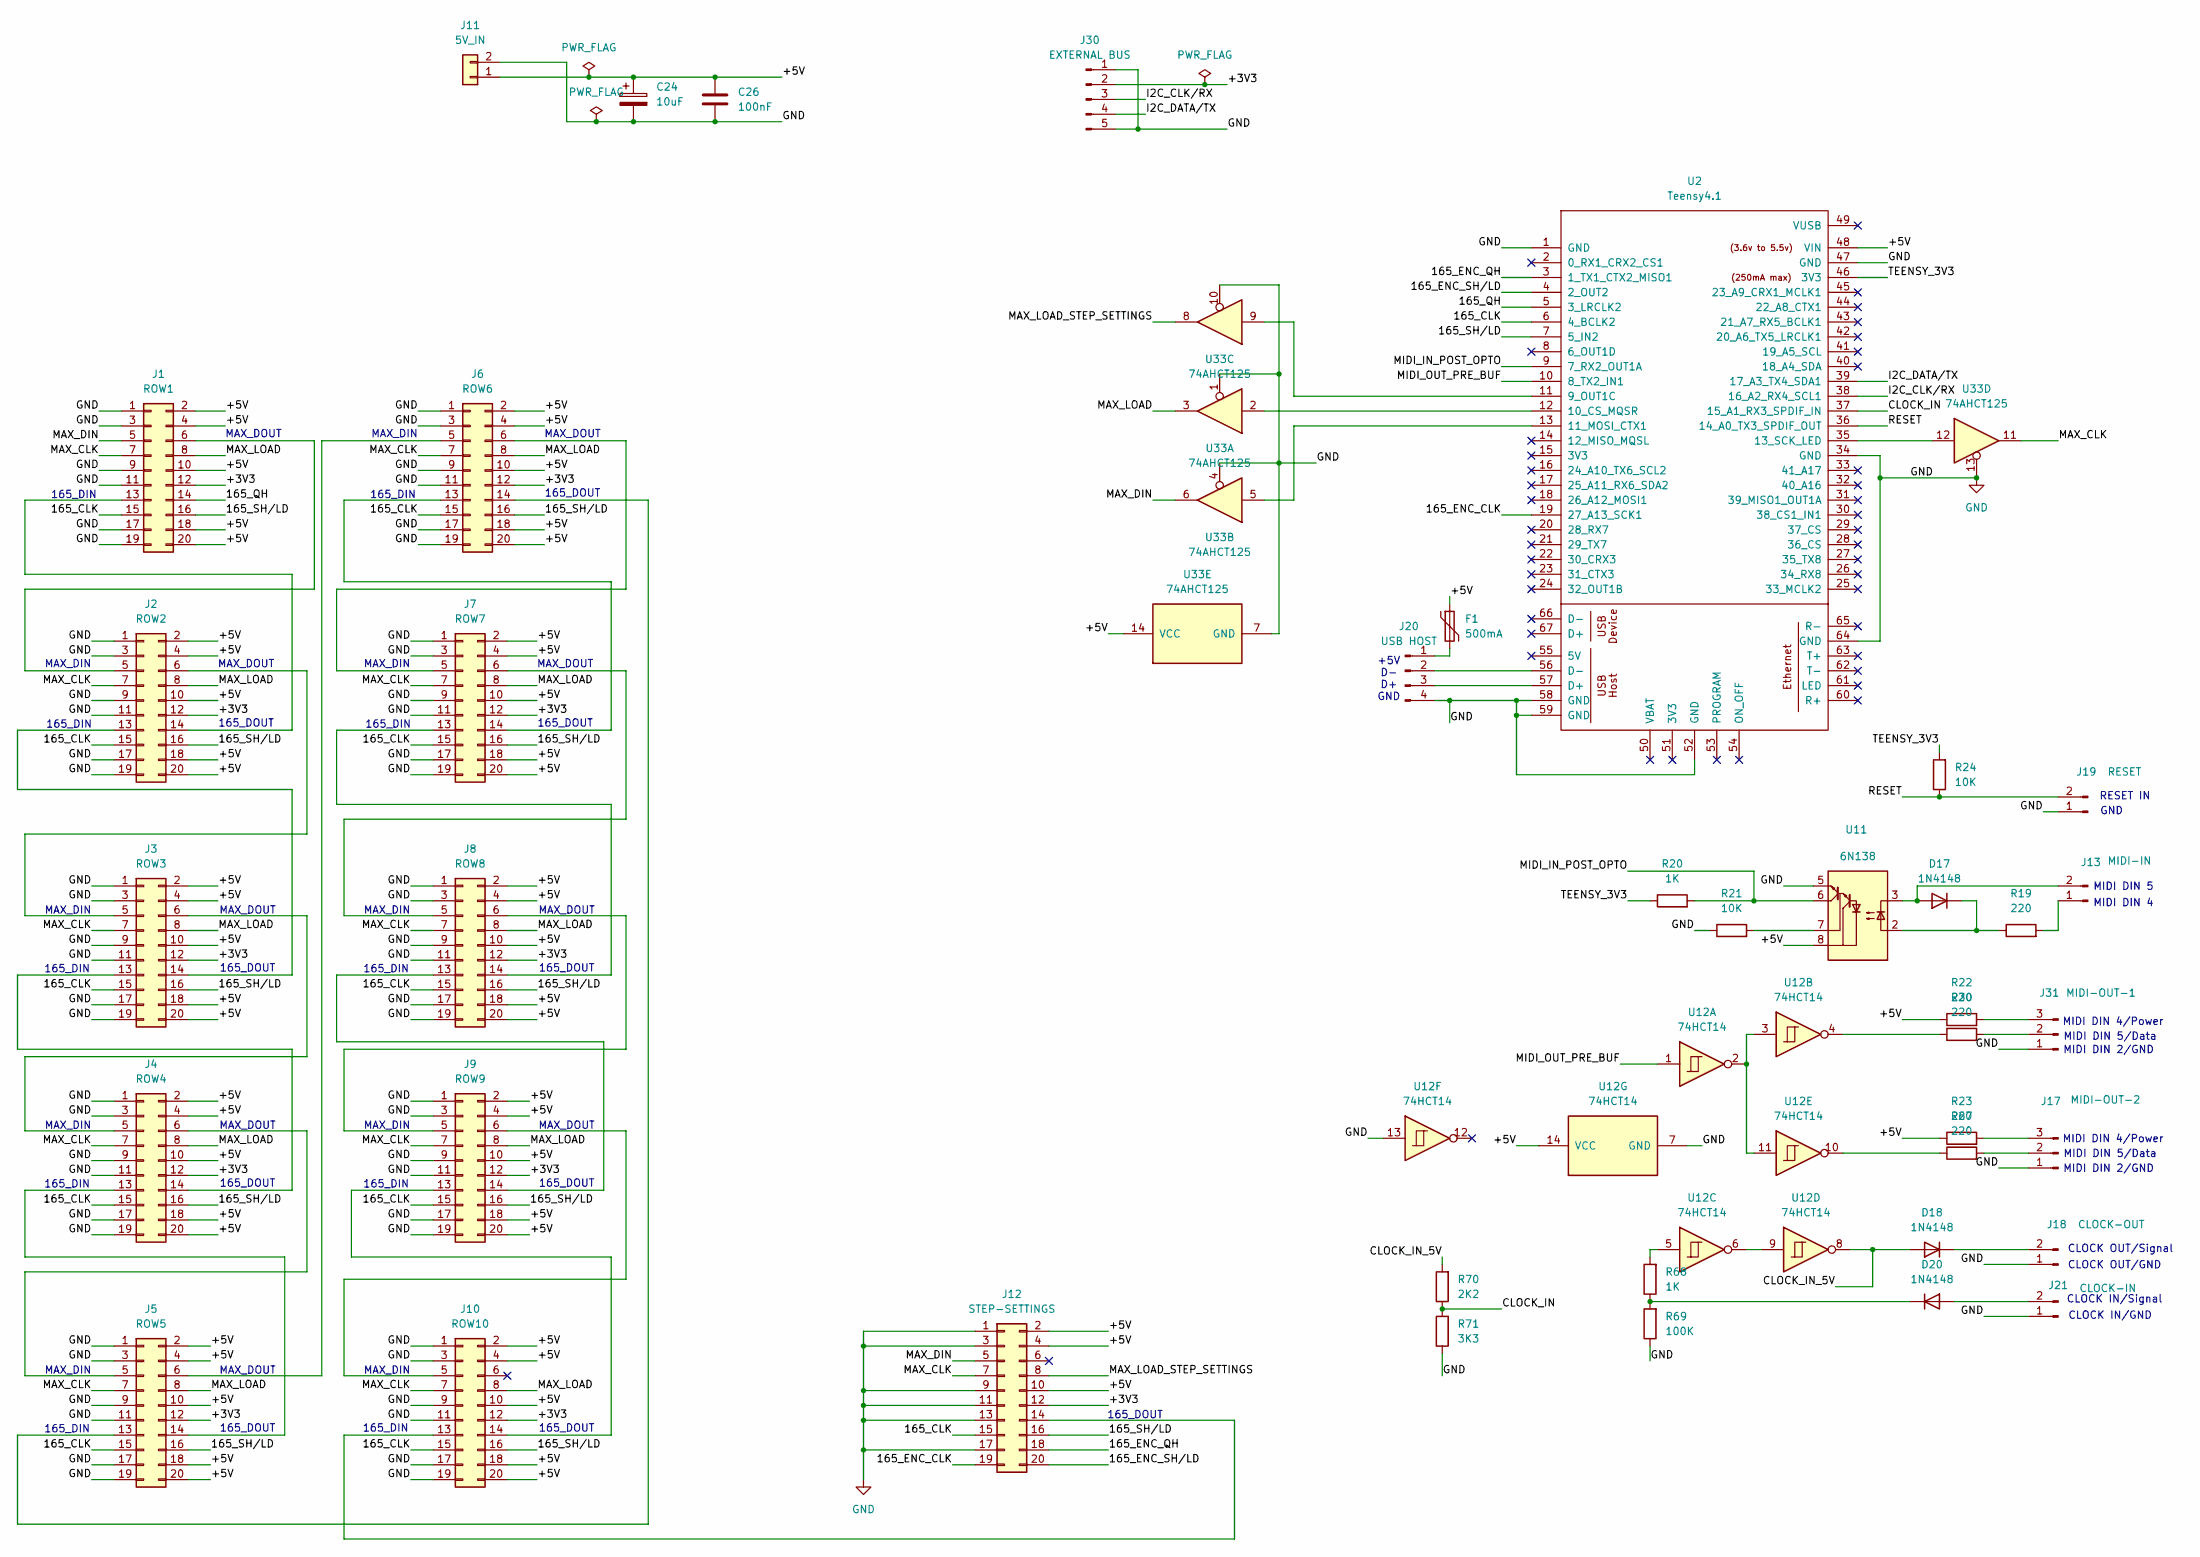
[picture p10: schematic kosmo-16-channel-sequencer-main-board.kicad_sch]

Parts:
C24: 10uF; CP_Radial_D6.3mm_P2.50mm
C26: 100nF; C_Disc_D5.0mm_W2.5mm_P5.00mm
D17, D18, D20: 1N4148; D_DO-35_SOD27_P7.62mm_Horizontal
F1: 500mA; Fuse_Bourns_MF-RHT050
J1: ROW1; PinHeader_2x10_P2.54mm_Vertical
J2: ROW2; PinHeader_2x10_P2.54mm_Vertical
J3: ROW3; PinHeader_2x10_P2.54mm_Vertical
J4: ROW4; PinHeader_2x10_P2.54mm_Vertical
J5: ROW5; PinHeader_2x10_P2.54mm_Vertical
J6: ROW6; PinHeader_2x10_P2.54mm_Vertical
J7: ROW7; PinHeader_2x10_P2.54mm_Vertical
J8: ROW8; PinHeader_2x10_P2.54mm_Vertical
J9: ROW9; PinHeader_2x10_P2.54mm_Vertical
J10: ROW10; PinHeader_2x10_P2.54mm_Vertical
J11: 5V_IN; TerminalBlock_Xinya_XY308-2.54-2P_1x02_P2.54mm_Horizontal
J12: STEP-SETTINGS; PinHeader_2x10_P2.54mm_Vertical
J13: MIDI-IN; PinHeader_1x02_P2.54mm_Vertical
J17: MIDI-OUT-2; PinHeader_1x03_P2.54mm_Vertical
J18: CLOCK-OUT; PinHeader_1x02_P2.54mm_Vertical
J19: RESET; PinHeader_1x02_P2.54mm_Vertical
J20: USB HOST; PinHeader_1x04_P2.54mm_Vertical
J21: CLOCK-IN; PinHeader_1x02_P2.54mm_Vertical
J30: EXTERNAL BUS; PinHeader_1x05_P2.54mm_Vertical
J31: MIDI-OUT-1; PinHeader_1x03_P2.54mm_Vertical
R19, R22, R23, R30, R67: 220; R_Axial_DIN0207_L6.3mm_D2.5mm_P7.62mm_Horizontal
R20, R68: 1K; R_Axial_DIN0207_L6.3mm_D2.5mm_P7.62mm_Horizontal
R21, R24: 10K; R_Axial_DIN0207_L6.3mm_D2.5mm_P7.62mm_Horizontal
R69: 100K; R_Axial_DIN0207_L6.3mm_D2.5mm_P7.62mm_Horizontal
R70: 2K2; R_Axial_DIN0207_L6.3mm_D2.5mm_P7.62mm_Horizontal
R71: 3K3; R_Axial_DIN0207_L6.3mm_D2.5mm_P7.62mm_Horizontal
U2: Teensy4.1; Teensy41
U11: 6N138; DIP-8_W7.62mm
U12: 74HCT14; DIP-14_W7.62mm
U33: 74AHCT125; DIP-14_W7.62mm

Connections:
/165_CLK: J1.15, J2.15, J3.15, J4.15, J5.15, J6.15, J7.15, J8.15, J9.15, J10.15, J12.15, U2.6 (4_BCLK2)
/165_ENC_CLK: J12.19, U2.19 (27_A13_SCK1)
/165_ENC_QH: J12.18, U2.3 (1_TX1_CTX2_MISO1)
/165_ENC_SH/LD: J12.20, U2.4 (2_OUT2)
/165_QH: J1.14, U2.5 (3_LRCLK2)
/165_SH/LD: J1.16, J2.16, J3.16, J4.16, J5.16, J6.16, J7.16, J8.16, J9.16, J10.16, J12.16, U2.7 (5_IN2)
/+3V3: J1.12, J2.12, J3.12, J4.12, J5.12, J6.12, J7.12, J8.12, J9.12, J10.12, J12.12, J30.2
/+5V: C24.1, C26.1, F1.1, J1.2, J1.4, J1.10, J1.18, J1.20, J2.2, J2.4, J2.10, J2.18, J2.20, J3.2, J3.4, J3.10, J3.18, J3.20, J4.2, J4.4, J4.10, J4.18, J4.20, J5.2, J5.4, J5.10, J5.18, J5.20, J6.2, J6.4, J6.10, J6.18, J6.20, J7.2, J7.4, J7.10, J7.18, J7.20, J8.2, J8.4, J8.10, J8.18, J8.20, J9.2, J9.4, J9.10, J9.18, J9.20, J10.2, J10.4, J10.10, J10.18, J10.20, J11.1, J12.2, J12.4, J12.10, R22.1, R23.1, U2.48 (VIN), U11.8 (VCC), U12.14 (VCC), U33.14 (VCC)
/CLOCK_IN: R70.1, R71.2, U2.37 (15_A1_RX3_SPDIF_IN)
/CLOCK_IN_5V: D18.2 (A), R70.2, U12.8
/I2C_CLK/RX: J30.3, U2.38 (16_A2_RX4_SCL1)
/I2C_DATA/TX: J30.4, U2.39 (17_A3_TX4_SDA1)
/MAX_CLK: J1.7, J2.7, J3.7, J4.7, J5.7, J6.7, J7.7, J8.7, J9.7, J10.7, J12.7, U33.11
/MAX_DIN: J1.5, J12.5, U33.6
/MAX_LOAD: J1.8, J2.8, J3.8, J4.8, J5.8, J6.8, J7.8, J8.8, J9.8, J10.8, U33.3
/MAX_LOAD_STEP_SETTINGS: J12.8, U33.8
/MIDI_IN_POST_OPTO: R20.2, U2.9 (7_RX2_OUT1A), U11.6 (VO2)
/MIDI_OUT_PRE_BUF: U2.10 (8_TX2_IN1), U12.1
/RESET: J19.2, R24.1, U2.36 (14_A0_TX3_SPDIF_OUT)
/TEENSY_3V3: R20.1, R24.2, U2.46 (3V3)
GND: C24.2, C26.2, J1.1, J1.3, J1.9, J1.11, J1.17, J1.19, J2.1, J2.3, J2.9, J2.11, J2.17, J2.19, J3.1, J3.3, J3.9, J3.11, J3.17, J3.19, J4.1, J4.3, J4.9, J4.11, J4.17, J4.19, J5.1, J5.3, J5.9, J5.11, J5.17, J5.19, J6.1, J6.3, J6.9, J6.11, J6.17, J6.19, J7.1, J7.3, J7.9, J7.11, J7.17, J7.19, J8.1, J8.3, J8.9, J8.11, J8.17, J8.19, J9.1, J9.3, J9.9, J9.11, J9.17, J9.19, J10.1, J10.3, J10.9, J10.11, J10.17, J10.19, J11.2, J12.1, J12.3, J12.9, J12.11, J12.13, J12.17, J17.1, J18.1, J19.1, J20.4, J21.1, J30.1, J30.5, J31.1, R21.1, R69.1, R71.1, U2.1 (GND), U2.34 (GND), U2.47 (GND), U2.52 (GND), U2.58 (GND), U2.59 (GND), U2.64 (GND), U11.5 (GND), U12.7 (GND), U12.13, U33.1, U33.4, U33.7 (GND), U33.10, U33.13
unnamed: D17.2 (A), J13.2, U11.3 (C2)
unnamed: D17.1 (K), R19.1, U11.2 (C1)
unnamed: D18.1 (K), J18.2
unnamed: D20.2 (A), J21.2
unnamed: D20.1 (K), R68.1, R69.2
unnamed: J1.6, J2.5
unnamed: J1.13, J2.14
unnamed: J2.6, J3.5
unnamed: J2.13, J3.14
unnamed: J3.6, J4.5
unnamed: J3.13, J4.14
unnamed: J4.6, J5.5
unnamed: J4.13, J5.14
unnamed: J5.6, J6.5
unnamed: J5.13, J6.14
unnamed: J6.6, J7.5
unnamed: J6.13, J7.14
unnamed: J7.6, J8.5
unnamed: J7.13, J8.14
unnamed: J8.6, J9.5
unnamed: J8.13, J9.14
unnamed: J9.6, J10.5
unnamed: J10.13, J12.14
unnamed: J9.13, J10.14
unnamed: J13.1, R19.2
unnamed: J17.2, R67.2
unnamed: J17.3, R23.2
unnamed: F1.2, J20.1
unnamed: J20.2, U2.56 (D-)
unnamed: J20.3, U2.57 (D+)
unnamed: J31.2, R30.2
unnamed: J31.3, R22.2
unnamed: R30.1, U12.4
unnamed: R67.1, U12.10
unnamed: R68.2, U12.5
unnamed: U2.11 (9_OUT1C), U33.9
unnamed: U2.12 (10_CS_MQSR), U33.2
unnamed: U2.13 (11_MOSI_CTX1), U33.5
unnamed: U2.35 (13_SCK_LED), U33.12
unnamed: R21.2, U11.7 (VO1)
unnamed: U12.6, U12.9
unnamed: U12.2, U12.3, U12.11

Notes on the sheet:
MAX_DIN
MAX_DOUT
MIDI DIN 2/GND
165_DOUT
165_DIN
MIDI DIN 4/Power
CLOCK IN/GND
MIDI DIN 5/Data
MIDI DIN 5
CLOCK OUT/GND
MIDI DIN 4
RESET IN
CLOCK OUT/Signal
+5V D- D+ GND
GND
CLOCK IN/Signal

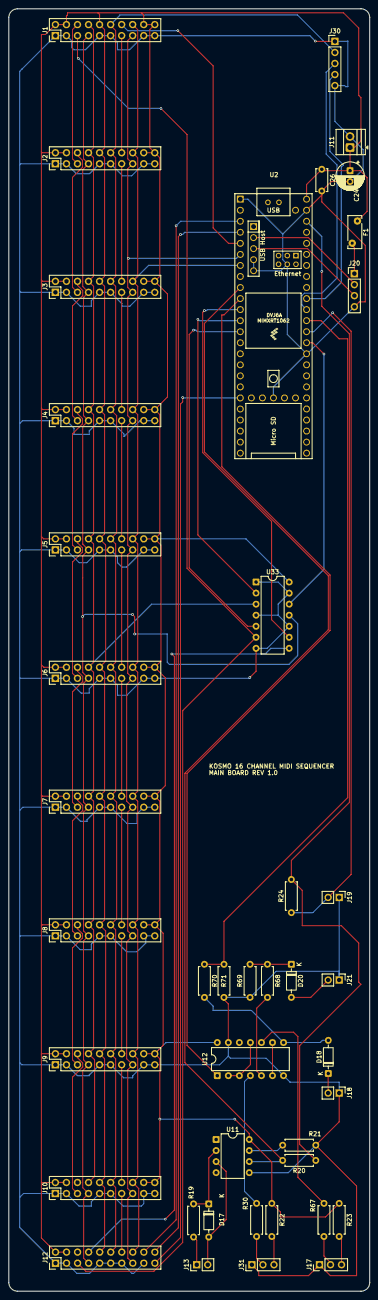
[picture p11: board kosmo-16-channel-sequencer-main-board.kicad_pcb from above]

Board: 2 copper layers, 83.0 x 295.0 mm, 42 parts (0 on the bottom side), 63 nets.
