tobydiamonds/kosmo-16-channel-midi-sequencer/(commit log)

2026-09-22 Add 16-channel sequencer hardware project
    KiCad 10 project containing three boards in a single PCB file
    (row board, step settings board, main/Teensy board), plus front
    panel artwork and mockup.
    Ignores KiCad local history and auto-backups (~106 MB combined,
    regenerated locally) and per-user state files.
    [bus-board.kicad_sch, kosmo-16-channel-sequencer.kicad_pcb, kosmo-16-channel-sequencer.kicad_sch, row-board.kicad_sch, step-settings-board.kicad_sch, untitled.kicad_sch]
2026-09-22 Split combined PCB into three one-board KiCad projects
    The single kicad_pcb held all three boards in one netlist, which made
    the shared power rails bleed across board outlines and produced one
    panelised Gerber set instead of three per-board sets.
    Now one project per board, each with a single outline:
    -main-board 83 x 295 mm 42 footprints (Teensy, MIDI, 165s)
    -row-board 377 x 49 mm 57 footprints
    -steps-settings-board 385 x 95 mm 98 footprints
    Each keeps its original root sheet as a thin wrapper around the one
    sheet symbol, so hierarchical net paths (/row-board/..., /step-settings-board/...)
    are unchanged and the PCB pad-net assignments stayed in sync.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
    [bus-board.kicad_sch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]
2026-09-22 added pcb labels
    [kosmo-16-channel-sequencer-main-board-B_Cu.gbr, kosmo-16-channel-sequencer-main-board-B_Mask.gbr, kosmo-16-channel-sequencer-main-board-B_Paste.gbr, kosmo-16-channel-sequencer-main-board-B_Silkscreen.gbr, kosmo-16-channel-sequencer-main-board-Edge_Cuts.gbr, kosmo-16-channel-sequencer-main-board-F_Cu.gbr, kosmo-16-channel-sequencer-main-board-F_Mask.gbr, kosmo-16-channel-sequencer-main-board-F_Pas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]
2026-09-22 house keeping
    [kosmo-16-channel-sequencer-main-board-B_Cu.gbr, kosmo-16-channel-sequencer-main-board-B_Mask.gbr, kosmo-16-channel-sequencer-main-board-B_Paste.gbr, kosmo-16-channel-sequencer-main-board-B_Silkscreen.gbr, kosmo-16-channel-sequencer-main-board-Edge_Cuts.gbr, kosmo-16-channel-sequencer-main-board-F_Cu.gbr, kosmo-16-channel-sequencer-main-board-F_Mask.gbr, kosmo-16-channel-sequencer-main-board-F_Pas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]
2026-09-22 fixed invalid net names
    [kosmo-16-channel-sequencer-main-board-B_Cu.gbr, kosmo-16-channel-sequencer-main-board-B_Mask.gbr, kosmo-16-channel-sequencer-main-board-B_Paste.gbr, kosmo-16-channel-sequencer-main-board-B_Silkscreen.gbr, kosmo-16-channel-sequencer-main-board-Edge_Cuts.gbr, kosmo-16-channel-sequencer-main-board-F_Cu.gbr, kosmo-16-channel-sequencer-main-board-F_Mask.gbr, kosmo-16-channel-sequencer-main-board-F_Pas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]
2026-09-22 Untrack fabrication output
    Gerbers, drill files and the job file are generated from the .kicad_pcb and go
    stale the moment a board changes, so they don't belong in version control. The
    committed set was already wrong: it predated the U33 DIP-12 -> DIP-14 footprint
    fix, the GND PWR_FLAGs and the net-name repair.
    The .kicad_pcb files are the source of truth; re-export before ordering.
    Files are removed from the index only and remain on disk.
    [kosmo-16-channel-sequencer-main-board-B_Cu.gbr, kosmo-16-channel-sequencer-main-board-B_Mask.gbr, kosmo-16-channel-sequencer-main-board-B_Paste.gbr, kosmo-16-channel-sequencer-main-board-B_Silkscreen.gbr, kosmo-16-channel-sequencer-main-board-Edge_Cuts.gbr, kosmo-16-channel-sequencer-main-board-F_Cu.gbr, kosmo-16-channel-sequencer-main-board-F_Mask.gbr, kosmo-16-channel-sequencer-main-board-F_Pas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]
2026-09-22 Ignore zipped fabrication archives in export folders
    Replaces the too-narrow *-gerber.zip pattern, which only matched one naming
    convention. **/export/*.zip catches the zip whatever it is called, at any
    depth, and stays scoped to export folders so unrelated archives elsewhere in
    the repo are still tracked.
2026-09-22 Ignore gerber zip archives
    The zips sit at each project root and archive that project's export/ folder,
    so **/export/*.zip never matched them. Every zip in this repo is generated
    output (gerber archives, KiCad auto-backups), so ignore the extension outright.
2026-10-14 Add row-board bring-up test, validated on hardware
    First power-up of any 16-channel sequencer board. The D1-D6 rainbow only
    renders correctly if the whole documented MAX7219 scheme is right, so this
    run validates all of it at once: the common-anode inversion (anode on SEG,
    three cathodes on three DIG lines), the non-identity pair->bit map
    {6,5,4,3,2,1,0,7}, the B,G,R plane order where DIG_0 is blue, and scan
    limit 0x05 at the drawn 33k RSET.
    Those last two were recorded nowhere but in one code snippet in
    docs/16-channel-sequencer-hardware.md, which warned that getting either
    wrong yields a lit, plausible-looking grid with the wrong colours in the
    wrong columns. They are now bench facts.
    Be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
